ufukyilmaz/NFS/(commit log)

2019-12-28 add sonar, potentiometer
2019-12-30 connect second motor, and make config
2019-12-30 add sonar, and simple auto mode
2020-01-01 add auto mode motor config
2020-01-07 add car image and circut schematic
2020-01-07 add flowcharts
